Hinata-344/WristMate_Orbit_OSS/hardware/v4_ESP32-C3-SuperMini/jlcpcb/production_files/BOM-WristMate_Orbit.csv

Comment | Designator | Footprint | LCSC | Quantity
LED | D98 | LED_0805 |  | 1
LED | D99 | LED_0805 |  | 1
~ | SW1 | slide_sw |  | 1
LED | D87 | LED_0805 |  | 1
LED | D84 | LED_0805 |  | 1
Motor_DC | M1 | VibrationMotor |  | 1
5.1k | R3 | CHIP_C_SMD |  | 1
LED | D63 | LED_0805 |  | 1
Battery_Cell | BT1 | 2Pin_Through_Hole_V2 |  | 1
1kR | R8 | CHIP_C_SMD |  | 1
CHRG_LED | D96 | CHIP_LED_SMD |  | 1
LED | D22 | LED_0805_over |  | 1
LED | D54 | LED_0805_over |  | 1
LED | D36 | LED_0805_over |  | 1
LED | D23 | LED_0805_over |  | 1
LED | D56 | LED_0805_over |  | 1
~ | U2 | TP4056_SMD |  | 1
1kR | R9 | CHIP_C_SMD |  | 1
LED | D37 | LED_0805_over |  | 1
LED | D58 | LED_0805_over |  | 1
390 | R1 | CHIP_C_SMD |  | 1
mameDenchi3v | J4 | SR416SW_2 |  | 1
10k | R13 | CHIP_C_SMD |  | 1
LED | D20 | LED_0805_over |  | 1
watch_mount | REF** | watch_mount |  | 1
Conn_01x11_Socket | J6 | 11pin_th_5_2pin |  | 1
0.1μF | C6 | CHIP_C_small_SMD |  | 1
0.1μF | C7 | CHIP_C_small_SMD |  | 1
LED | D82 | LED_0805 |  | 1
LED | D35 | LED_0805_over |  | 1
LED | D9 | LED_0805_over |  | 1
LED | D13 | LED_0805_over |  | 1
LED | D70 | LED_0805 |  | 1
LED | D86 | LED_0805 |  | 1
BMA400 | U6 | XDCR_BMA400 |  | 1
4.7k | R16 | CHIP_C_SMD |  | 1
1kR | R6 | CHIP_C_SMD |  | 1
STDBY_LED | D95 | CHIP_LED_SMD |  | 1
LED | D53 | LED_0805_over |  | 1
LED | D72 | LED_0805 |  | 1
LED | D49 | LED_0805_over |  | 1
LED | D66 | LED_0805 |  | 1
LED | D62 | LED_0805 |  | 1
1kR | R10 | CHIP_C_SMD |  | 1
LED | D88 | LED_0805 |  | 1
LED | D94 | COB_LED_Chip |  | 1
LED | D90 | LED_0805 |  | 1
SW_Push | SW3 | SW_Silent |  | 1
LED | D32 | LED_0805_over |  | 1
LED | D29 | LED_0805_over |  | 1
LED | D81 | LED_0805 |  | 1
LED | D59 | LED_0805_over |  | 1
LED | D5 | LED_0805_over |  | 1
4.7k | R15 | CHIP_C_SMD |  | 1
LED | D55 | LED_0805_over |  | 1
LED | D80 | LED_0805 |  | 1
LED | D60 | LED_0805_over |  | 1
100R | R14 | CHIP_C_SMD |  | 1
10k | R7 | CHIP_C_SMD |  | 1
PNP | Q3 | SOT23-BEC |  | 1
LED | D11 | LED_0805_over |  | 1
1kR | R12 | CHIP_C_SMD |  | 1
1k | R18 | CHIP_C_SMD |  | 1
LED | D76 | LED_0805 |  | 1
LED | D1 | LED_0805_over |  | 1
LED | D31 | LED_0805_over |  | 1
1kΩ | R17 | CHIP_C_SMD |  | 1
LED | D65 | LED_0805 |  | 1
LED | D61 | LED_0805 |  | 1
LED | D44 | LED_0805_over |  | 1
LED | D41 | LED_0805_over |  | 1
LED | D6 | LED_0805_over |  | 1
LED | D17 | LED_0805_over |  | 1
RTC_rv3028 | J5 | RV-3028-C7 |  | 1
LED | D52 | LED_0805_over |  | 1
LED | D30 | LED_0805_over |  | 1
~ | SW2 | slide_sw |  | 1
LED | D10 | LED_0805_over |  | 1
NPN | Q2 | NPN_MMBT3904 |  | 1
LED | D71 | LED_0805 |  | 1
LED | D67 | LED_0805 |  | 1
LED | D27 | LED_0805_over |  | 1
5.1k | R2 | CHIP_C_SMD |  | 1
LED | D7 | LED_0805_over |  | 1
LED | D57 | LED_0805_over |  | 1
LED | D75 | LED_0805 |  | 1
LED | D15 | LED_0805_over |  | 1
LED | D4 | LED_0805_over |  | 1
LED | D46 | LED_0805_over |  | 1
LED | D47 | LED_0805_over |  | 1
~ | U5 | FS8205A |  | 1
1k | R5 | CHIP_C_SMD |  | 1
LED | D39 | LED_0805_over |  | 1
0.1uF | C1 | CHIP_C_small_SMD |  | 1
Conn_01x05_Socket | J3 | 6pin_pad_mount_hole |  | 1
LED | D43 | LED_0805_over |  | 1
LED | D78 | LED_0805 |  | 1
LED | D18 | LED_0805_over |  | 1
LED | D83 | LED_0805 |  | 1
LED | D77 | LED_0805 |  | 1
LED | D64 | LED_0805 |  | 1
LED | D8 | LED_0805_over |  | 1
LED | D2 | LED_0805_over |  | 1
LED | D51 | LED_0805_over |  | 1
LED | D38 | LED_0805_over |  | 1
LED | D16 | LED_0805_over |  | 1
LED | D3 | LED_0805_over |  | 1
LED | D40 | LED_0805_over |  | 1
LED | D74 | LED_0805 |  | 1
0.1uF | C3 | CHIP_C_small_SMD |  | 1
1k | R11 | CHIP_C_SMD |  | 1
LED | D12 | LED_0805_over |  | 1
LED | D24 | LED_0805_over |  | 1
LED | D21 | LED_0805_over |  | 1
LED | D33 | LED_0805_over |  | 1
LED | D34 | LED_0805_over |  | 1
LED | D42 | LED_0805_over |  | 1
LED | D73 | LED_0805 |  | 1
LED | D45 | LED_0805_over |  | 1
LED | D48 | LED_0805_over |  | 1
PNP | Q1 | SOT23-BEC |  | 1
0.1uF | C2 | CHIP_C_small_SMD |  | 1
LED | D93 | COB_LED_Chip |  | 1
LED | D79 | LED_0805 |  | 1
10u | C5 | CHIP_C_SMD |  | 1
LED | D85 | LED_0805 |  | 1
LED | D89 | LED_0805 |  | 1
0.1uF | C4 | CHIP_C_small_SMD |  | 1
D | D97 | CHIP_R_SMD |  | 1
~ | U4 | CDS |  | 1
LED | D26 | LED_0805_over |  | 1
10k | R4 | CHIP_C_SMD |  | 1
LED | D50 | LED_0805_over |  | 1
USB_C_Receptacle | J1 | USB_C_Receptacle_GCT_USB4125-xx-x_6P_TopMnt_Horizontal |  | 1
LED | D19 | LED_0805_over |  | 1
LED | D68 | LED_0805 |  | 1
LED | D28 | LED_0805_over |  | 1
 | draw | 8b95931c-af33-4c21-b8dc-b51557f3a42e |  | 1
LED | D14 | LED_0805_over |  | 1
LED | D69 | LED_0805 |  | 1
~ | U3 | DW01A |  | 1
LED | D25 | LED_0805_over |  | 1
Conn_01x11_Socket | J7 | 11pin_th_5_2pin |  | 1
Conn_01x05_Socket | J2 | 6pin_pad |  | 1
IS31FL3733-QF | U1 | QFN-48-1EP_6x6mm_P0.4mm_EP4.2x4.2mm |  | 1
LED | D91 | COB_LED_Chip |  | 1
