Hinata-344/WristMate_Orbit_OSS/hardware/v5_XIAO-ESP32S3_Encoder/WristMate_Orbit.kicad_pcb

## KiCad design hardware/v5_XIAO-ESP32S3_Encoder/WristMate_Orbit.kicad_pcb (2026-11-11)

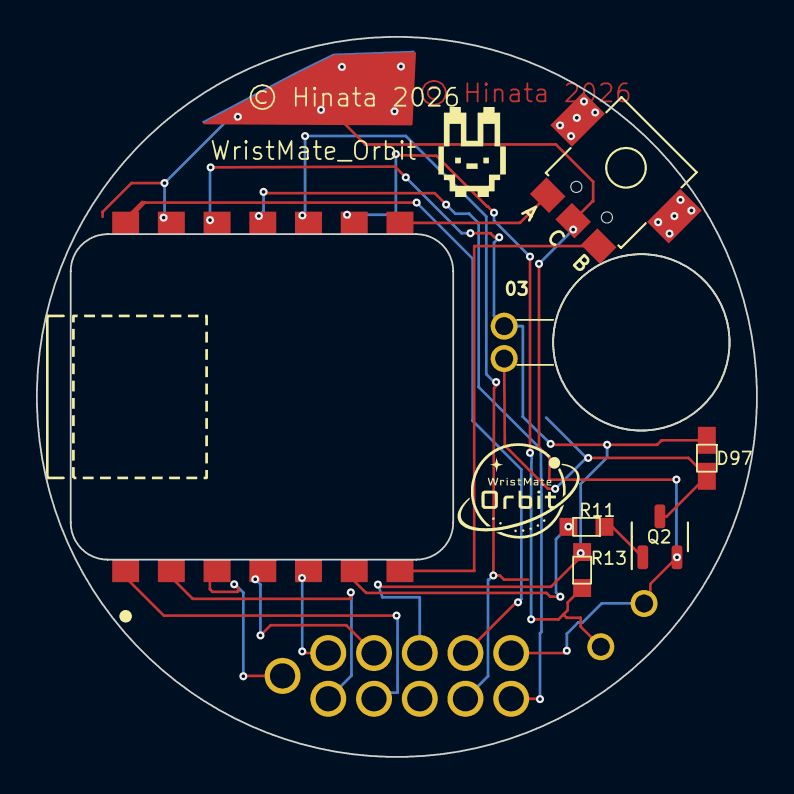
[picture p2: board hardware/v5_XIAO-ESP32S3_Encoder/WristMate_Orbit.kicad_pcb from above]

Board: 2 copper layers, 40.0 x 40.0 mm, 10 parts (1 on the bottom side), 16 nets.

Parts:
D97: D; CHIP_R_SMD
ENC1: EC05E1220401
J7: Conn_01x11_Socket; 11pin_th_5_2pin
M1: Motor_DC; VibrationMotor
Q2: NPN; NPN_MMBT3904
R11: 1k; CHIP_C_SMD
R13: 10k; CHIP_C_SMD
U4: CDS
XIAO1: XIAO-ESP32-S3-SMD; XIAO-ESP32-S3_cutted_
draw: 8b95931c-af33-4c21-b8dc-b51557f3a42e

Connections:
+3.3VA: D97.1 (K), J7.3, M1.1 (+), R13.2, XIAO1.12 (3V3_OUT)
+5VA: J7.2, XIAO1.14 (VBUS)
BMA_INT1_base: J7.8, XIAO1.1 (D0)
CDS: R13.1, U4.1, XIAO1.9 (D8)
COB: J7.7, XIAO1.2 (D1)
ENC_A: ENC1.B, XIAO1.7 (D6)
ENC_B: ENC1.A, XIAO1.8 (D7)
GND3: ENC1.C, J7.1, Q2.3 (E), U4.2, XIAO1.13 (GND)
LED_DRIVER_en: J7.6, XIAO1.3 (D2)
unnamed: D97.2 (A), M1.2 (-), Q2.1 (C)
unnamed: Q2.2 (B), R11.1
RV_INT_base: J7.10, XIAO1.10 (D9)
SCL_base: J7.5, XIAO1.5 (D4)
SDA_base: J7.4, XIAO1.4 (D3)
SW: J7.11, XIAO1.11 (D10)
VIBE_DRV: R11.2, XIAO1.6 (D5)
