Hinata-344/WristMate_Orbit_OSS/(commit log)

2026-11-11 初回: ファームウェア(v5用)と基板 v4/v5 の KiCad
    自宅のWi-Fi情報と駅の時刻表は伏せた(時刻表はサンプルに置き換え)。
    [BOM-WristMate_Orbit.csv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]
2026-11-11 写真とライセンス(MIT / CC BY 4.0)を追加
2026-11-11 v5 基板をエンコーダ付きの版に差し替え、画像をカバー1枚に
    [BOM-WristMate_Orbit.csv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]
