Hinata-344/WristMate_Orbit_OSS/(notices)

Notices in the files:
parts and their libraries:
© Hinata 2026
